Aluminium51/Hardware_Synthesis_Laboratory/docs/tasks/TASK-003-basic-filters.md

# TASK-003 Basic Filters

## Status
Complete / hardware passed.

Date completed: 2026-04-22
Hardware validation: 2026-05-07

Implemented:
- raw, grayscale, negative, and threshold modes
- 4-bit `gray4 = (R + 2*G + B) >> 2` grayscale value
- threshold comparison in the same 4-bit domain: `gray4 >= threshold[3:0]`
- top-level control mapping now uses `sw[1:0]` for mode, `sw[5]` for VGA-only test-pattern debug mode, and `btnU` / `btnD` for stored 4-bit threshold adjustment. `sw[2]` is reserved for temporary camera-path diagnostics and does not change filter behavior.

Verification:
- `iverilog -g2012 -o sim/run/tb_video_filter_basic.vvp rtl/filters/video_filter_basic.v sim/tb/tb_video_filter_basic.sv`
- `vvp sim/run/tb_video_filter_basic.vvp`
- Result: filter simulation passed for raw, grayscale, negative, threshold, mode switching, and default raw behavior.
- Result: top-level Icarus Verilog elaboration passed with switch-controlled filter integration.
- Result: Basys 3 hardware validation passed as part of the completed baseline. Live camera video can be displayed in raw, grayscale, negative, and threshold modes using `sw[1:0]`; `btnU` / `btnD` adjust the threshold value.

## Goal
Implement the baseline display modes on the VGA readout path:
- raw
- grayscale
- negative
- threshold

## Why this task exists
The assignment requires three distinct real-time hardware filters with a way to switch between them.
This task implements those filters in the simplest architecture: after framebuffer readout.

## Scope
In scope:
- one filter-selection module
- mode select input mapping
- grayscale implementation
- negative implementation
- threshold implementation
- passthrough raw mode
- filter testbench

Out of scope:
- edge detection
- line buffers
- convolution kernels
- camera integration changes

## Files allowed to change
- `rtl/filters/video_filter_basic.v`
- `rtl/top/top_basys3_ov7670_vga.v`
- `sim/tb/tb_video_filter_basic.sv`
- optional docs if formulas or mode mapping change

## Required behavior
Mode mapping:
- `00` raw
- `01` grayscale
- `10` negative
- `11` threshold

### Grayscale
Produce a grayscale approximation from RGB444.
A simple weighted approximation is acceptable.

### Negative
For each 4-bit channel:
- `out = 15 - in`

### Threshold
- compute a grayscale or luminance-like value
- compare it against a threshold control
- output full white or full black

## Implementation notes
- Grayscale uses a 4-bit `gray4 = (R + 2*G + B) >> 2` value.
- Threshold compares in the same 4-bit domain: `gray4 >= threshold[3:0]`.
- Top-level filter control uses Basys 3 switches/buttons: `sw[1:0]` for mode, `btnU` / `btnD` for threshold up/down, and `sw[5]` for VGA-only test-pattern debug. `sw[2]` is a temporary camera-path LED diagnostic control.
- `btnC` resets the design and restores the stored threshold to its default mid-scale value.
- `sw[4:3]` select the reset-sampled camera profile at the top level.

## Deliverables
- synthesizable filter module
- stable mode select behavior
- testbench covering at least one case per mode
- top-level control hookup using switches or simple static control for testing

## Done when
1. Simulation shows each mode behaving correctly.
2. Raw mode preserves input unchanged.
3. Negative mode inverts channels correctly.
4. Threshold mode produces only black or white output.
5. Filter switching works without modifying framebuffer contents.

## Common failure modes
- accidentally filtering before storage instead of after readout
- incorrect 4-bit inversion arithmetic
- threshold comparing the wrong value range
- mode select not synchronized or not wired correctly
