Aluminium51/Hardware_Synthesis_Laboratory/docs/decisions/ADR-003-single-buffer-first copy.md

# ADR-003 Single Buffer First

## Decision
Start with one framebuffer only.

## Status
Accepted.

## Rationale
- simplest architecture for first light
- avoids frame-swap control complexity
- baseline correctness is more important than removing tearing in the first milestone
