Aluminium51/Hardware_Synthesis_Laboratory/docs/diagrams/schematic.pdf

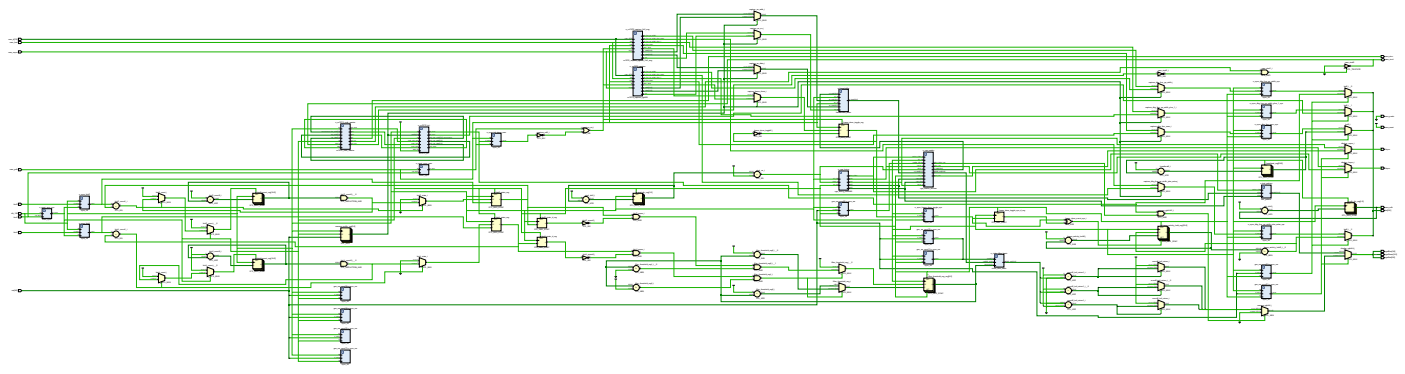
[picture p1: page 1]
cam_d[7:0] cam_href cam_vsync; cam_pclk; btnD; clk_100 btnC; btnU; u_reset_sync_sys; reset_sync; clk; rst_async; rst_sync; u_sync_btnD; sync_2ff; clk d_async; q_sync; rst; u_sync_btnU; btnD_count1_i RTL_EQ; btnU_count1_i RTL_EQ; btnD_count_i RTL_MUX; S=default I1; btnU_count_i RTL_MUX; btnD_count0_i RTL_ADD; btnD_count_i__0 RTL_MUX; btnU_count0_i RTL_ADD; O[18:0] btnU_count_i__0 RTL_MUX; btnD_count_reg[18:0] RTL_REG_SYNC CD; RST; btnU_count_reg[18:0] RTL_REG_SYNC CD; u_ov7670_sccb_master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

capture_frame_done_i RTL_MUX S=default I1 S=1'b1 I0 O S

frame_done_toggle0_i RTL_INV
I0 O = | | | S=default I1 O S+

vgaBlue[3:0] vgaGreen[3:0] vgaRed[3:0]
