Aluminium51/Hardware_Synthesis_Laboratory/rtl/filters/edge_sobel.v

// Reserved for a future Sobel edge-detection filter.
//
// Edge detection is outside the stable baseline scope. The baseline display
// modes are implemented in video_filter_basic.v on the VGA readout path.
