Aluminium51/Hardware_Synthesis_Laboratory/(commit log)

2026-04-22 TASK-002: BRAM framebuffer read path and 2x VGA scaling validated on hardware
2026-04-22 Chore: Add TASK-006-camera-capture
2026-04-22 TASK-003: add basic readout-path filters with switch-controlled mode selection
2026-05-09 FEAT: solve left and uppper bar near edge, add both internal and on-board full frame downscaling to half frame, add report doc about fine tuning registers for lower noise
    [basys3_ov7670_vga.xdc, framebuffer_bram.v, ov7670_capture_rgb565_2x2_avg.v, ov7670_init.v, ov7670_reg_rom.v, tb_ov7670_capture.sv, tb_ov7670_capture_2x2_avg.sv, tb_ov7670_init.sv]
